mashdup/LEDWallSimulator/(commit log)

2026-10-07 LED curtain wall: browser is the brain, ESP32 is a dumb pixel sink
    1m^2 panel, 400 WS2812B, 20x20 at 50mm pitch. The browser fetches the
    banner, rasterises it, applies effects, budgets the power, and streams
    finished frames. The firmware decodes frames and pushes pixels; it has
    no layout map, no effects, and no idea what a picture is. The sim and
    the wall speak the same frame protocol, so nothing in web/ is throwaway.
    core/ framebuffer, layout map, frame protocol, power model, effects
    (pure JS: no DOM, no fetch, runs under Node so it is testable)
    web/ banner page, canvas sim, live-page capture UI, sinks
    tools/ headless-Chromium capture over CDP + the /capture route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
2026-10-07 name: match the package to the repo
    led-wall -> led-wall-simulator, matching github.com/mashdup/LEDWallSimulator.
    npm rejects uppercase, so the repo's three words land in kebab case.
    Only the package name changes. web/sinks.js CHANNEL stays 'led-wall': it is
    the cross-tab contract both tabs must agree on, not a package identifier.
    plan.md keeps its original 'led-wall/' layout sketch, which is a historical
    proposal rather than a description of this tree.
2026-10-13 lock in: milestones 1-5 as a working tree, panel lit on GPIO 21
    Everything since Oct 7 sat uncommitted, so there was no state to come back to.
    This is that state, as verified on hardware tonight.
    What is here: core framebuffer/layout/pack, the frame protocol with its rewind
    budget, the power budget and clamp, colour, calibration patterns; tools/bridge.js
    (Node driver plus VirtualWall, a port of the sketch's loop), serve.js and
    capture.js (page -> PNG -> frames), png.js, ports.js, start.js; web app.js frame
    loop, sim, banner, panner, and the sim/broadcast/serial/http sinks; firmware.ino
    with APA106/PL9823 bit timing generated straight out of the RMT.
    Verified on the real panel: GPIO 21 driv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
2026-10-13 firmware: STALE_MS=0 disables the watchdog, so a stalled host holds instead of blinking
    The fade exists so that a dead host is visible, but from the wall's side a host
    that merely stalled is identical to one that died. Chrome throttles timers in a
    background tab to ~1 Hz, and to once a minute after five minutes hidden, so a tab
    that is not in front spends longer than STALE_MS between frames and the wall blinks
    black every time it does. Measured: an 18 s stream from Node that stalled once
    reported stale=1 - one blink out of a run that was otherwise perfect
    (disc=0 resync=0 rewind=0 gaps=0).
    With STALE_MS=0 the compare is against a compile-time constant and the branch drops
    out entirely. Veri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
2026-10-13 firmware: report the reset reason and a boot count in the status line
    A board that reboots mid-stream blanks the wall, and from the host's side that is
    indistinguishable from a stream fault: every counter is clean, the panel still
    blinks, and there is nothing to look at. `rst` is esp_reset_reason() and `boots`
    counts resets without a power cycle, held in RTC noinit memory behind a magic word
    so a cold start can be told from a restart.
    This is what ruled out a brownout: full white at br=85 (est=8000 mA, the ceiling
    the 8000 mA default allows) for 585 frames at 30 fps left boots=1, with
    disc=0 resync=0 rewind=0 gaps=0. The supply holds the wall's real load.
2026-10-13 firmware: bank the stream counters in RTC memory so they outlive a reset
    A browser session ends in a reset (rst=11, ESP_RST_USB, delivered through the
    USB-Serial-JTAG interface) and that reset zeroes every counter, so each session
    destroyed the only evidence of what it had delivered. That is why measuring a
    browser session kept returning zeros - the instrument was wiped by the event it
    was meant to observe.
    rtcLive is refreshed once a second and a new boot banks it into rtcPrev, so
    `prev=frames/discarded/rewinds/gaps` in the status line reports what the previous
    session reached. Validated end to end: stream 120 frames, reset the board, and
    the next boot reports prev=120/0/0/0 with boots=2.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
2026-10-13 power: clamp against the worst frame of the recent past, not the frame in hand
    brightnessFor() derived k from the current frame's own ink, so a scrolling banner
    made the wall's global brightness a function of the picture: measured at the
    default 8000 mA budget, k swung between 0.88 and 1.00 through 38 distinct values
    in twelve seconds, and raising the limit to 24000 did not change it. Every byte
    and every counter stayed correct throughout - the decoder reported disc=0
    resync=0 rewind=0 gaps=0 over 1529 frames - which is why this looked like a
    hardware fault for so long.
    The class comment already described the right thing: "the largest brightness
    multiplier that keeps the worst frame SEEN SO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
2026-10-13 docs: the S3 board is 16 MB of flash, not N8R8/8 MB
    `esptool flash-id` on the actual part: manufacturer 0x68, device 0x4018, 16 MB,
    quad, 3.3 V. This file had claimed N8R8/8 MB throughout, which is exactly the kind
    of detail that only bites when you flash someone else's image: tonight it sent me
    to the 8 MB WLED build, and then `--flash-size 8MB` overrode the image's own
    header, so the chip booted into "SHA-256 comparison failed ... Attempting to boot
    anyway" and a TG0WDT reset loop that looks like a dead board.
    Records both traps: esptool reports "Hash of data verified" because it verifies
    with the parameters it wrote, so a mode or size mismatch passes its check and only
    fails in the bootl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
2026-10-13 tools/channels: step each colour channel and watch the panel, and record the method
    No counter on the device can see whether light comes out. `est` non-zero,
    `state=live` and `rmt=1` are all satisfied by a sketch that decodes frames
    perfectly onto a pin connected to nothing, which is exactly the trap this project
    fell into more than once: a green dashboard and a dark wall.
    channels.js sends one channel at a time - RED, GREEN, BLUE, WHITE, OFF, then red
    and blue again - over a solid field, while printing frames, seq, disc, rewind,
    gaps, state and boots from the same port. Counters climbing with one colour
    missing points at that channel's mapping or output stage; counters climbing with
    nothin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
2026-10-13 web: an Adalight sink, so the browser can drive WLED over USB
    The wall is driven by WLED. Its Apa106 RMT method is the only driver proven
    against these beads, and this sketch's own bit timing has never been validated on
    this panel. But the page could only speak this repo's 1203-byte protocol, so
    pointing Web Serial at WLED fed its parser a stream it has no header for.
    AdalightSink frames each record the way WLED's serial realtime input expects:
    'A' 'd' 'a', the LED count high/low, hi ^ lo ^ 0x55, then the record's 1200-byte
    payload unmoved - 1206 bytes on the wire. Meta records are accepted and dropped,
    because WLED has no field for them and brightness rides in the frame bytes.
    SerialSink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
2026-10-13 web: the Adalight header carries the LED count MINUS ONE
    Found by reading WLED's parser rather than guessing. wled00/wled_serial.cpp:
    case AdaState::Header_CountLo:
    count += next + 1; // plus one while reading the two count bytes
    ...
    if (--count > 0) state = AdaState::Data_Red; // consumes exactly `count`
    Adalight's header holds count - 1; that is the convention, not an off-by-one in
    WLED. We sent 400, so WLED read 401 pixels: 1203 bytes off a 1200-byte payload,
    swallowing the next frame's first three header bytes. That header never matches,
    so the whole record is discarded as garbage, and the frame after it may sync
    again - frames landing intermittently.
    Th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
2026-10-13 docs: WiFi starves WLED's serial path, and Adalight's count is LED_COUNT - 1
    Two findings that between them explain a flickering wall with a byte-perfect
    stream, both documented upstream rather than derived:
    wled/WLED#2698 reports Adalight-over-serial glitching "in random colours" and
    traces it to "interference by wifi activity, proportional to traffic to/from
    WLED", with disabling WiFi on the ESP as the workaround. Reproduced on this wall:
    with 400 LEDs streamed at a fixed 16 frames/s, WLED refreshed 12 fps on a quiet
    network and 8 fps while its HTTP API was polled 20 times a second. WiFi traffic
    starves the serial receive path; the frames that lose the race are dropped, and
    Adalight has n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
2026-10-13 docs: the USB-CDC route to WLED glitches on this board - use DDP
    Measured: solid green at 15 fps for 40 s over the S3's USB-CDC port, quiet network,
    nothing else attached, WLED's output off - still glitching. That matches
    espressif/arduino-esp32#9378 ("[HWCDC] Missing data via USB Serial on C3/C6/S3"),
    which reports the S3 dropping bytes on its native USB serial.
    Adalight has no resync, so one dropped byte corrupts the rest of that frame and the
    frame after it. Both USB attempts here - the Node probe and the browser's adalight
    sink - glitch for that reason. It is a platform fault, not a framing one: the count
    field and checksum are now verified correct against WLED's parser, and the frames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
2026-10-13 docs: the venue runbook - WLED's own AP plus DDP, no infrastructure needed
    A party has no WiFi network, which rules out the DDP route as previously framed but
    not the idea: the wall needs a link between the laptop and the ESP32, not the
    internet, and WLED provides that link itself. Set AP Behaviour to Always, join
    WLED-AP from the laptop (192.168.4.1 by default), point the dev server at it with
    --ddp, and drive the app's http sink. Only the DDP datagrams leave the machine.
    DDP is also the one path that this evening measured clean on this panel - 42
    frames, 0 dropped, smooth sweep, smooth banner - and it is unaffected by the WiFi
    activity that starves the serial route, because it is the netw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
2026-10-13 wled: a custom build whose serial sink resyncs, so the offline route works
    WLED drives this panel smoothly with its own Apa106 RMT method, and the sketch drives
    it smoothly over Web Serial, but WLED-over-serial flickers. The failure is the
    transport, not the framing: the ESP32-S3's native USB serial loses bytes
    (espressif/arduino-esp32#9378) and Adalight has no resync, so one lost byte corrupts
    the rest of that frame and the next. WiFi makes the drops worse (wled/WLED#2698).
    This adds a tracked overlay over a pinned WLED clone (the clone itself is ignored;
    setup.sh fetches it). It changes two things and nothing else. First, the sink speaks
    the repo's own 0xA5/0xA4 records, decoded exactly a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
2026-10-13 docs: the custom WLED sink is verified on the panel - USB-OTG costs frames, not pixels
    Flashed led_wall_s3_usb to the board (COM6, the S3's own USB-OTG) and the panel
    lights, renders the calibration cycle and holds it steady. Driven with the repo's
    own host, `node tools/bridge.js --port COM6 --cycle --duration 15000`, the sink
    reported 305 frames sent, 295 decoded, and disc=resync=rewind=11: ten lost-byte
    events, every one self-healed by the rescan, and zero corrupted frames.
    That is the point of the build. The transport is still the buggy USB-CDC port and
    still drops about 3% of the bytes, but the resync that core/frame.js already
    specified turns each loss into a skipped frame; Adalight, w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
2026-10-13 docs: the UART build is lossless - 400 of 400 frames, no discards, no rescans
    Moved the cable to the board's UART port (the CH9102F, VID_1A86&PID_55D3, came up as
    COM8) and flashed led_wall_s3_uart. Same firmware and same framing as the USB-OTG
    build; the only difference is that Serial is on UART0 instead of the S3's native USB.
    A moving gradient at 20 fps for 20 s: 400 records sent, frames=400, meta=1,
    disc=0 resync=0 rewind=0 gaps=0, state=live. Nothing lost, nothing discarded,
    nothing rescanned. Repeating it with one frame deliberately a payload byte short
    gave disc=1 resync=1 rewind=1 across 240 good frames - every real frame still
    arrived and the corruption stayed confined to the frame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
2026-10-13 wled: silence the radio on the UART build, by compiling the manager out rather than racing it
    Turn the ESP32's radio off for the streamed wall (wled/WLED#2698) and keep it off.
    The obvious version does not work, and trying it produced a worse wall than leaving
    WiFi on, so the measurement is worth recording.
    WiFi.mode(WIFI_OFF) does not hold on its own: WLED::handleConnection() runs every loop
    and re-inits the stack whenever it believes it is disconnected. Instrumented with a
    woff= counter, the radio came back every ~9 s and the usermod took it down again each
    time - frames=91 disc=0 resync=0 woff=1, then frames=109 disc=6 resync=1159 woff=2,
    then frames=281 disc=12 resync=2027 woff=3. A tea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
2026-10-13 tools/wallcheck: stream the wall and read its counters in one connection
    The device counters are the only thing that can say "the bytes arrived" from "the
    bytes were lost", and reading them the obvious way lies twice.
    The CH9102F asserts DTR/RTS on open and this board's auto-reset circuit is wired to
    it, so opening the port reboots the ESP32. Read the counters in a different
    connection from the one that streamed and the answer is always a freshly-booted
    zero - which is exactly how the first bridge.js runs looked like frames=0 while the
    wall was fine. And a still wall is not re-sent frame by frame, so a static pattern
    measures almost nothing; this streams a moving gradient where every frame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
2026-10-14 tools/wallcheck: verified on the wall, and the one reset gap is a restart rather than a fault
    First hardware run, and the tool was wrong before the wall was: the transport came
    back clean - disc=0 resync=0 rewind=0, 300 of 300 frames decoded - and wallcheck
    still failed the run on gaps=+1.
    The gap is the stream restart. The sink tracks the last sequence it saw so it can
    report a dropped frame, but it does not print that number back, so a fresh run cannot
    continue it and this tool always starts at 0. On a board that has already been
    streamed to, the first frame of every run is therefore one gap, and failing on it
    would fail every healthy run. Past that one, a gap is still unexplained and sti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
2026-10-14 layout: calibrated on the real panel - columns of 20, straight, top->bottom
    Milestone 5, read off the wall with WALK and INDEX_MAP: index 0 is top-left,
    each strip runs down a column and restarts at the top of the next column
    left->right, 399 is bottom-right. Not serpentine. core/layout.js defaults are
    now stripAxis 'y', snake false, no flips: index = 20*col + row.
    identity() now pins stripAxis 'x': its contract is physical == logical, and
    the new default was silently making it column-major. preview() joins columns
    with a space: padStart(3) cannot separate adjacent 3-digit indices, which the
    column layout's first row (0,20,...,380) hits.
    Verified end-to-end: a logical top-left 'F' packed t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
2026-10-14 web: brightness was applied twice - the wall showed k-squared
    The page scaled the frame bytes by the power clamp k AND carried k in the
    meta record; the sketch folds the meta brightness into renderWall() and the
    DDP transport applies it to the frames that follow, so the serial and DDP
    walls displayed k*k. The bridge never scaled bytes - brightness rode only
    in meta - which is why the same wall was bright through tools/bridge.js and
    dim through the page.
    Brightness now applies once, at the sink:
    - the wire carries raw bytes; meta carries the clamp.
    - meta is re-sent when the clamp moves, so the wall's applied brightness
    tracks k instead of freezing at whatever the first frame asked for.
    -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
2026-10-14 power: full white spiralled k to the floor - the wall sat at br=13/255
    Two faults, one panel:
    brightnessFor returned a local k while observe() decayed this.k and toMeta()
    reported this.k - two brightness states. The page applied one and the wall
    was told the other.
    observe() fired its multiplicative decay against effectiveLimitMa, the very
    margin brightnessFor aims a clamped frame at. A full-white panel at limit
    18000 lands the rendered estimate at 16260 mA against the 16200 target -
    integer rounding a hair over - so every frame multiplied k by ~0.9996 with
    no recovery path. Sustained white spiralled to the minBrightness floor:
    k=0.05, meta br=13, a dull wall at 5% with the slider looking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
2026-10-14 web: headroom changes the margin, so its handler must reset the ratchet
    The adaptive ceiling is one-way by design - only reset() brightens the wall
    back - and the limit slider honoured that contract while the headroom slider
    did not. Raising headroom clamped k (visible: the wall dims); lowering it
    recovered nothing, because the ratchet held the clamp and the wall was never
    told. The handler now mirrors the limit handler: set the margin, reset, and
    re-send meta so the wall's applied brightness rides the reset k.
    Regression test: full white at 18000 mA, headroom 0.1 -> 0.9 -> 0.1. The
    clamp hardens on the way up, the ratchet provably holds without a reset,
    and a reset returns k to the 0.675 t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
2026-10-14 docs: the power envelope is the ribbon, measured - 6-7 A, supply-independent
    Probe test on the live wall: the last column alone at full white is very
    bright, so the far corner gets full voltage at low current. Lighting
    columns progressively, the probe dims at 5 columns (~6-7 A), and the
    full-white ramp knee sits near 42% ink. A 20 A and a 40 A supply made no
    difference - the ribbon, not the supply, is the ceiling. Full white's 24 A
    is unreachable; br above ~100 buys heat, not light.
    The ribbon ran cold to the touch and the page's 8000 mA default keeps the
    estimator's margin just above the collapse zone, so it stays. The
    headroom move, if brightness must grow, is a second power pair to the f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
2026-10-14 web: content.html - the companion canvas the wall renders
    A 400x400 canvas, 20 css px per LED cell, black is off, pixel-aligned
    blocks map 1:1 through the capture's area-average. window.WALL is the
    script API for the interactive webapp that follows: set/rect/clear, grid,
    cell, ctx, canvas - draw from rAF and the wall follows at the poll rate.
    ?wall=1 hides the human panel so the page is exactly 400x400: a page
    taller than the capture viewport gets shot as a scaled full-page image,
    and the panel text bleeds into the wall's field of view. Verified through
    the real pipeline: capture route -> 1:1 PNG -> pageSource at 20 px/cell,
    no pan -> live animation on the physical panel.
    App settings: sou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
2026-10-14 web: worker clocks - the stream and the canvas survive a hidden tab
    Chromium throttles a hidden tab's timers to ~1 Hz and stops
    requestAnimationFrame entirely. The app's 30 fps setTimeout loop crawled
    at ~1 fps the moment the tab lost focus, and content.html's rAF demo
    froze - the wall slowed or stalled whenever either tab went to the
    background.
    Workers are exempt from background throttling and their postMessage
    handlers run at full rate on the main thread, so the tempo moves into
    one: web/worker-clock.js is a Blob worker that ticks at a fixed period,
    and both pages drive off it. The app keeps full frame rate with the tab
    in the background; the content canvas animates with the tab hidden.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
2026-10-14 web: silent-audio keep-alive - Chrome throttles hidden tabs' workers too
    The worker clock kept the tempo off the main thread, but Chrome 88+
    aligns the timers of a hidden page's WORKERS to ~1 Hz as well: an
    unfocused app tab streamed at 1 fps, measured. The documented in-page
    escape is the audio exemption - a page with an active audio stream is
    not background-throttled.
    keep-alive.js opens a WebAudio graph that is inaudible in practice (an
    oscillator under a gain of 1e-5) and starts it from a gesture the user
    already performs: Connect on the app page, demo on the content page.
    Idempotent, one stream per page.
    worker-clock's doc now says what is actually true: the clock beats
    main-thread sc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
2026-10-14 content protocol: the driver tab can now drive the content page
    content.html was an island: the wall rendered it, but nothing on the
    driver side could say what it should show. BroadcastChannel + a
    validated protocol in core closes the loop: the app page grew a Content
    control fieldset (Send text / Fill / Clear / Demo) and content.html
    consumes the commands - text scrolls through the same core Scroller the
    app's text mode uses, so one banner implementation serves both hosts.
    core/content-protocol.js is the single authority: makeMessage throws on
    an illegal payload (a broken sender fails loudly at its call site),
    parseMessage drops anything malformed on the receiving side (a content
    page neve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
2026-10-14 content: animation library + control gallery
    Six new named animations, each a pure function of the server clock -
    no local state, no Math.random (deterministic hashed texture), so every
    renderer - tabs, control pages, the wall's capture browser - is in
    phase at the same second:
    bounce ball on Lissajous paths with a fading trail
    rain column drops at hashed speeds, bright head, fading tail
    fire hot base, heat decaying upward, noise scrolled by time
    plasma three overlapping sine waves, hue from the sum
    bars equalizer waves, green/yellow/red by height
    clock real wall clock from the server epoch - the wall keeps time
    Protocol: ANIM_NAMES is the anim vocabulary (demo, bo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
2026-10-14 content: wrap the epoch clock before periodic math - fixes jitter
    Phase t is seconds since the epoch (~1.8e9). t*12 sits at 2e10, where
    a double's spacing is ~4000: (t*speed) % 26 quantizes into thousand-
    cell jumps, hue = ... + t*12 quantizes into thousand-degree jumps.
    Rain teleported, plasma flickered, everything read as 'constantly
    restarting' - arithmetic precision, not animation state.
    animDraw now wraps t to one hour before any periodic expression (the
    wrap discontinuity is once an hour, invisible), and 'clock' - the one
    animation that must see the raw epoch to show real time - takes tRaw
    separately.
2026-10-14 serve: GET /content.at is the server's CURRENT time - fixes sawtooth clock
    Renderers rebase their animation clock on every poll:
    serverNow = GET.at + elapsed-since-poll. But GET returned content.at -
    the timestamp of the LAST POST - so every 100 ms poll snapped every
    page's clock back to the moment of the last command. Animations
    advanced 100 ms, got yanked to the start, advanced, yanked: 'constantly
    redrawing from the start', measured as an oscillating pixel sample
    (39,22,39,27,18,27,18,43) and now as smooth monotonic drift
    (10,14,31,51,75,112,153,194).
    GET.at is Date.now() at request time; the POST time stays as postedAt.
    Regression test: two GETs 300 ms apart must show at advancing - the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
2026-10-14 content push: the wall fetches the page's own frames - 3x the rate
    The /capture route photographs a page at 60-90 ms per shot: the wall's
    content rate topped out near 10 fps no matter what the app's 30 fps
    loop wanted - the observed 'closer to 15, not smooth'. Remove the
    photographer: content.html POSTs its canvas to the server after every
    draw; the app fetches the freshest bytes in a few milliseconds.
    The pushed frame is a 20x20 snapshot - that IS the wall's resolution.
    Encoding 400x400 (PNG ~100 ms, JPEG ~90 ms, measured headless) capped
    the push near 8-10 fps; 20x20 JPEG encodes in ~1 ms and the push runs
    at the full draw rate (measured: every fetch in 2s returned a new
    frame). Auto-zoom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
2026-10-14 app tab generates the wall's frames - a hidden content tab can't freeze it
    Measured diagnosis: the push pipeline ran ~21 fps with a live content
    tab, but the user's hidden content tab pushed at 0.3 fps - Chrome
    throttles hidden tabs (and their workers) hard, and the wall froze on
    the last frame it saw. The pusher was the weakest link: any hidden tab
    can starve the wall.
    Move frame generation to the app tab - the driver holds the audio
    keep-alive from the Connect click, is never throttled, and is the
    brain anyway. core/animations.js is the library in canvas-free pure
    form: animFrame(state, serverTime) -> flat RGB, the same phase
    discipline as content.html (epoch wrapped to an hour before per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
2026-10-14 app: 'Content - server push' feed (presets as a unit) + y-axis layout default
    The push pipeline's five page-mode fields (endpoint, refresh,
    auto-zoom, speed, URL) are one decision, and one field set wrong is a
    frozen or stuttering wall. New Feed option 'Content - server push'
    applies them together: endpoint /content/frame (the app tab generates
    frames, never throttled), refresh 34 ms (one poll per tick), auto-zoom
    on (the pushed frame is 20x20 - the wall's own resolution), speed 0
    (panning a 20x20 source is a shake), URL this server's content page.
    Layout dropdown now defaults to the calibrated mounting - '20x20
    columns of 20 (straight)', stripAxis 'y' from LAYOUT_DEFAULTS - not
    identity, w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
2026-10-14 app: leaving the content feed restores capture defaults
    The content feed's presets leaked: Content -> Live web page left
    endpoint=/content/frame, and the frame route ignores the url
    parameter - page mode answered every poll with the pushed 20x20
    frame, so the page capture looked completely dead. Reproduced in a
    real browser: after switching back, endpoint still read
    /content/frame.
    Presets that go in pairs go out in pairs: setSourceMode('page')
    restores endpoint /capture and refresh 150 ms. Verified: after
    content -> page, a real URL captures (1280x800, 45 ms round trip).
2026-10-14 page: a source without a hash must DECODE - fixes the frozen content feed
    PageSource.refresh decoded only when X-Capture-Hash changed. The push
    route sent no hash: key=null, initial key=null, 'null !== null' is
    false, so the first frame was never decoded - the content feed sat at
    'capturing…' forever, 0 captures, black wall. The comment claimed a
    null key meant 're-decode every poll'; the code did the opposite.
    - page.js: key === null now means decode.
    - serve.js: the push route sends X-Capture-Hash (sha256 of the frame)
    and X-Capture-Ms (frame age), the same contract /capture offers, so
    identical frames skip decode and the readout shows real latency.
    - app.js: any first pointerdown a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
2026-10-14 push: PNG not JPEG at 20x20 - pixel art demands exact colors
    JPEG's 8x8 blocks are 40% of a 20x20 frame each, so compression
    artifacts land directly on LED cells: the demo's orange square came
    out light orange ringed with red/green. JPEG was right at 400x400
    (where encoding was the bottleneck); at the wall's native 20x20,
    PNG encodes in ~1 ms and is lossless.
    Measured in a real browser: push ~19-29 fps (probe-capped), decoded
    frames contain the exact source palette - demo orange (255,136,0)
    and green (0,255,102) pixel-exact, zero artifact pixels. (The
    'other' colors in one probe were fire embers: the live control tab
    was driving the server state. Exact values, lossless confirmed.)
2026-10-14 keep-alive: be AUDIBLE to Chrome, or the exemption never applies
    Chrome's hidden-tab throttling exemption is for tabs it measures as
    playing audio, and the measurement is amplitude-based with a floor
    around -50 dB. The keep-alive sine at 1e-5 gain (-100 dB) is below
    that floor: Chrome heard nothing, applied throttling anyway, and a
    backgrounded app tab crawled (measured in headless: 4.4 fps hidden
    vs 32 fps visible; the silent and audible gains measure identically
    in headless because it has a fake audio device and no audible
    detection at all).
    Now: 0.02 gain (-34 dB, comfortably above the floor) at 19.5 kHz -
    Chrome flags the tab audible and exempts it; almost no adult hears
    a 19.5 kHz tone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
2026-10-14 keep-alive: escape BOTH throttling tiers - media element for the 5-minute cliff
    Symptom: smooth for a few minutes hidden, then 1 Hz. That is Chrome's
    intensive throttling: after ~5 minutes hidden, timers drop to one
    wake-up per minute. The audible WebAudio sine escapes the STANDARD
    tier (hence the smooth minutes) but not reliably the intensive one.
    The documented escape for the intensive tier is active media
    playback, so the keep-alive is now both:
    - tier 1: audible WebAudio sine (19.5 kHz, -34 dB) - immediate
    hidden-tab throttling
    - tier 2: a looping <audio> element playing the same tone as a
    runtime-generated 1-second WAV data URI (no asset, no network) -
    the media-playback exemptio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
2026-10-14 start: --app was dropped on the no-port path - npm run wall opened a tab
    The real bug, found by instrumenting the call site: parseArgs has two
    returns, and the no-port early return omitted 'app'. Plain 'npm run
    wall' (no --port) therefore ran with app=undefined and fell through
    to openInBrowser - a tab in the default browser. Every verification
    I ran passed --port, took the explicit-port return (which had 'app'),
    and saw a real app window - so the tests proved the flag worked while
    the user's exact command silently ignored it.
    Fix: the early return carries app too. Verified with the user's flow
    (plain 'npm run wall', fallback port): run 1 chromeH=39 APP WINDOW,
    run 2 chromeH=39 APP WINDOW.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
2026-10-14 electron: the wall as a real app - tab lifecycle removed at the root
    Direction change after the Chrome --app whack-a-mole (throttling
    tiers, occlusion, delegation, session restore, and --no-sandbox
    measured to silently kill app mode): Electron is the same Chromium
    engine with the lifecycle owned by the app.
    - tools/electron/main.cjs: one window, no menu, backgroundThrottling
    false (OUR decision, not a tab policy), single-instance lock that
    focuses the existing window, Web Serial granted with a
    programmatic port picker (COM8 preferred - the wch.cn USB-UART),
    fixed title 'LED Wall'.
    - start.js --electron: boots the server, launches the app, relays
    its output with an 'electron:' pref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
2026-10-14 electron: dedicated userData dir + legible single-instance outcome
    'npm run wall exited (code 0)' was the single-instance lock working
    against a leftover test instance: the newcomer focused the old
    window (pointing at a dead test server) and quit silently, while
    two instances fought over the default %APPDATA% cache dir
    ('Unable to move the cache: Access is denied').
    - userData moves to .wall-electron in the repo (known location,
    gitignored).
    - The newcomer now SAYS what happened: 'another wall instance is
    already running - focused it', with the fix (close the old one).
    - The launcher relay drops the newcomer's transient cache errors;
    everything else stays visible.
    Verified: launch 1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
2026-10-14 electron: drop windowsHide - the window was born hidden
    'Started, no window' measured at the OS level: all 4 electron
    processes alive, MainWindowHandle = 0 - no window on the desktop -
    while the renderer loaded and show() fired. windowsHide:true sets
    STARTF_USESHOWWINDOW/SW_HIDE on the process, and Electron's browser
    window HONORS that startup hint (Chrome's --app window did not,
    which is why the same flag looked harmless before). Without it,
    MainWindowTitle 'LED Wall' appears. Electron is a GUI binary, so
    there is no console window to hide anyway.
    Also: createWindow now shows on ready-to-show with explicit
    center() + focus() and logs its bounds, so 'no window' is
    answerable from the launch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
2026-10-14 electron+app: a serial connection must name its device
    'COM8 isn't connected, clicking Connect says connected, nothing
    works': the programmatic picker fell back to ports[0] - with the
    panel unplugged that is some unrelated COM device (Bluetooth,
    audio). open() succeeds on it, writes go into a void, the UI says
    'connected: serial' over a dead wall.
    - main.cjs: match the DEVICE, not the COM number - wch.cn
    usbVendorId 0x1a86 / 'USB Serial' / CH34x product strings, COM8
    as a hint only. No candidate -> REFUSE, and log the full port
    list with product names to the launcher (the old picker matched
    'COM8' in the path, but the wch UART reports usbProductName
    'USB-SERIAL CH340' - the real d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
2026-10-14 electron: picker read the WRONG port struct - Electron's SerialPort
    Field log: '3 port(s): undefined[?], undefined[?], undefined[?]'
    while Windows had CH343 on COM8. The select-serial-port portList is
    Electron's SerialPort struct - portName, displayName, vendorId/
    productId (strings), deviceInstanceId (win32) - NOT the Web Serial
    API's SerialPortInfo (path, usbProductName, usbVendorId) I matched.
    Every field read was undefined, so the CH343 never matched and the
    picker refused a healthy device.
    Match on Electron's real fields: displayName wch|ch34|usb serial,
    vendorId '1a86', deviceInstanceId vid_1a86, portName COM8 hint,
    then any COMn. Raw objects are dumped per request so the next
    diagnos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
2026-10-15 serial pre-flight: name a taken port before Connect, not after
    A COM port is exclusive; when the Arduino monitor (or a stale
    bridge) holds COM8, port.open() fails with the opaque 'Failed to
    open serial port' AFTER the click, with no hint who holds it.
    - tools/serial.js: PowerShell test-opens each COM port from
    outside the app -> [{port, state: FREE|BUSY}], cached 3 s.
    Documented side effect: opening toggles DTR/RTS, which reboots
    a connected ESP32 - so the app probes on load, not on a timer.
    - GET /serial in serve.js (no-store).
    - app.js: on load, busy ports surface as
    'warning: COM8 in use by another program - close its serial
    monitor before connecting' in the sink status.
    - 4 te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
2026-10-15 freeport: force-disconnect = find the holder, name it, kill it
    Windows COM ports are exclusive and no API closes another process's
    handle; the only 'force disconnect' is terminating the holder. The
    pre-flight says 'COM8 is busy' - this names WHO.
    tools/freeport.js: the handle.exe algorithm via PowerShell Add-Type.
    NtQuerySystemInformation enumerates every handle; duplicate + type
    each. Measured census on this machine: serial handles are object
    type 'File' (there is NO 'Device' type), and naming File objects is
    the classic NtQueryObject hang (pipes) - so File handles are named
    on 16 parallel worker threads with a 100 ms budget, hung queries
    abandoned (background threads; the probe process ex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
2026-10-15 app: control page folded into the main view; layout UI simplified
    Content control was a BroadcastChannel stub pointing at the companion
    page - dead weight now that the app tab generates frames and the
    server is the source of truth. The control page's power is now IN
    the app:
    - Content fieldset: text (Enter sends), fill, clear, and the full
    animation gallery (8 buttons from ANIM_NAMES). Commands POST to
    /content - validated by makeMessage here, parseMessage at the
    server.
    - Status mirrors the server on the SAME 100 ms poll that drives
    frames (no second fetch loop): 'server rev N - showing: rain',
    and the live animation's button is lit (.on) so the panel shows
    what the wall shows.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
2026-10-15 serial: probe timeout crashed the SERVER - the two regressions explained
    'Connection doesn't work + content feed blank' after the pre-flight
    landed: tools/serial.js's timeout timer called ps.kill('ignore').
    'ignore' is a POSIX-only signal convention; on Windows it throws
    ERR_UNKNOWN_SIGNAL. The timer runs on the dev server's event loop,
    so a PowerShell cold start slower than the 5 s timeout (measured:
    it happens) raised an uncaught exception and took the whole server
    down. Every symptom follows: no /content (blank feed), no /serial,
    Connect dead - all blamed on the app.
    - Valid signal only (SIGTERM/TerminateProcess), wrapped in try/catch.
    - Timeout 5 s -> 15 s: PowerShell cold start measure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
2026-10-15 text: the banner SCROLLS - seek() takes cells, not a fraction
    'Word appears, never moves': the frame pusher fed Scroller.seek()
    the pass FRACTION (0..1) where seek takes a CELL offset in
    [0, period). The text rendered under one cell from the start and
    wrapped every pass - visible, and stone still. Both renderers had
    the same line (app pushContentFrame and content.html's draw loop).
    Fix: fraction * scroller.period. Verified in a real browser: two
    pushed frames 1.5 s apart differ (lit-pixel hash moves as the
    banner passes).
    Regression test (content-sync): app tab on the content feed, POST
    text, two /content/frame fetches 1.5 s apart must NOT be
    byte-identical PNGs - a frozen banner is now a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
2026-10-15 css: responsive layout - the page stopped outgrowing its own width
    The app page scrolled sideways: the sim sat half off screen and the
    control panel ran past the window. Four compounding causes, all
    structural (no media query fixes a min-content floor):
    - Grid tracks: minmax(360px,1fr) + minmax(340px,420px) set hard
    floors (~760px total), and grid ITEMS default to min-width:auto,
    so a long readout or the long wallLayout option widened tracks
    past the viewport. Tracks are now minmax(0,1fr)/minmax(300px,420px)
    and .stage/.panel/fieldset carry min-width:0.
    - .row never wrapped: the content fieldset alone carries eleven
    buttons (send/fill/clear + the 8-anim gallery) in one flex line.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
2026-10-15 serial: reset into RUN MODE on open - kill-and-relaunch worked no more
    Kill the app while connected, launch again, Connect succeeds, the
    wall is dark. The app's death leaves DTR/RTS at an arbitrary level,
    and the ESP32 auto-reset circuit (DTR->IO0, RTS->EN through
    transistors) reads that as 'stay in the bootloader'. The port
    opens, writes succeed, nothing arrives - 'connected' over a dead
    wall, nothing in any log to say why.
    Fix: SerialSink.open() pulses an esptool-style hard reset after
    opening - IO0 released (DTR deasserted), reset pulsed on EN (RTS),
    released - the chip reboots into the firmware. Frames that arrive
    during the ~2 s boot are discarded by the parser's 0xA5 resync,
    not mis-p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
2026-10-15 start: --debug flag - Electron DevTools on 127.0.0.1:9223
    'Connected, wall dark' and 'connect failed' look identical from the
    launcher log. The app page's own state (fps counter, seq, sink
    status, last frame error) is the evidence, and Electron exposes
    none of it by default. 'npm run wall -- --debug' passes
    --remote-debugging-port=9223 to Electron so the app page can be
    inspected from outside while the show runs.
2026-10-15 electron --debug: interpret the flag as an APP arg in main.cjs
    Everything after main.cjs on the Electron command line is an app
    argument, not a Chromium switch: passing --remote-debugging-port
    raw from the launcher did nothing (9223 never listened). main.cjs
    now sees '--debug' in process.argv and appends the switch
    programmatically before ready.
2026-10-15 start: wire --debug through; kill zombie serve.js at startup
    Two gaps from the kill-and-relaunch investigation:
    1. --debug never reached Electron: an earlier multi-edit call fails
    atomically (one oldText missed -> ALL edits discarded), and only
    one of the three was re-applied. serveOnce never took the debug
    parameter and openElectronWindow(ready[1]) never passed it. Now
    wired end to end; verified the arg reaches the spawn.
    2. The root cause of 'kill the app, relaunch, connect fails': a
    dead launcher's tree does not always die - the orphaned serve.js
    holds port 8080 (new show lands on a random port, splitting the
    stack) and the orphaned Electron holds COM8 (open() fails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
2026-10-15 anim: 'snitch' - the Golden Snitch, HP-themed
    A night sky of faintly twinkling hashed stars, and a gold comet
    darting along a noise-perturbed Lissajous - the erratic flit of
    something with wings. Analytic trail (past positions sampled from
    the same pure function, fading gold), glow cross around the core.
    Pure function of server time like every animation: identical frame
    in every renderer at the same second, no state, no local clock.
    Registered in ANIM_NAMES (gallery button appears automatically);
    implemented in both renderers (core/animations.js for the app's
    frame push, content.html's inline library).
    Tests: the ANIM_NAMES-driven suites cover it automatically (lit,
    advances, pure); a dedi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
2026-10-15 connect: clear the DRIVER-level port lock (the works/fails/works alternation
    The measured pattern - fresh app works, close, relaunch fails, close,
    relaunch works - is not a process holding the port (freeport finds no
    holder in the failing state): the wch driver leaves the port
    un-openable for a while after a connected app closes. The tell is
    that the FAILING instance cleans up for the NEXT one: the serial
    probe test-opens every port on page load, and that open/close
    releases the zombie lock - so the failed instance's probe is what
    makes the third launch work.
    Takeover now handles the no-holder case: open fails, scan finds no
    process holder -> the lock is in the driver -> run one fresh probe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
2026-10-15 serial: THE PULSE WAS THE BUG - DTR asserted = IO0 HIGH (esptool reset_to_run)
    The report: relaunch says 'connected: serial - COM8', the app
    streams, and the wall is dark - and the failure ALTERNATES
    (works, fails, works). Case 2: the port opens fine; the chip is
    stranded in the bootloader.
    Root cause, from the classic DTR->IO0 / RTS->EN transistor circuit:
    DTR asserted -> Q1 off -> IO0 HIGH -> boots into FIRMWARE
    DTR deasserted -> Q1 on -> IO0 LOW -> boots into BOOTLOADER
    The dcba5d7 pulse left DTR deasserted while pulsing RTS - so the
    chip came out of reset with IO0 LOW: straight into the bootloader.
    The rescue pulse itself was the stranding. And the driver's close
    defaults (bot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
2026-10-19 draw: a 20x20 editor, a server-side gallery, and pic/gallery content
    The wall is a family noticeboard as much as a data display, so anyone who
    can reach it can put a picture on it.
    - core/drawings.js the model: one flat RGBA grid, 4 bytes per cell,
    20x20 = 1600 bytes; the wire form is lowercase hex of those bytes
    (3200 chars). Alpha is the whole transparency story - a cell with a=0 is
    NOT USED, so it renders as nothing and the wall's black shows through.
    Empty is not white and not black: it is off, which is what a curtain of
    LEDs does with a cell nobody addressed.
    - web/draw.html standalone editor, touch-first: pencil / eraser /
    bucket, native picker + quick palette + rec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
2026-10-19 anim: the APP driver played the demo where a drawing belongs
    Reported straight after the drawing feature: send a drawing, the wall shows
    the demo animation. There are TWO frame renderers and only one of them
    knew about the new kinds. content.html paints pic/gallery; when the wall
    runs in the app's content feed - the normal mode, because the app tab holds
    the audio keep-alive and a hidden content tab throttles to ~1 Hz and
    starves the push - the frames come from animFrame(), whose switch had no
    pic/gallery case, so both fell through to default: the demo.
    - core/animations.js pic paints its own cells (a=0 is zero, the wall's
    off state; junk pixels give a black frame, never a throw, because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
2026-10-19 web/draw-editor.js: the editor, lifted out of draw.html
    draw.html and the guest page need the SAME editor - the model, the pointer
    stroke, the undo stack, the flood fill, the tool and color state - and only
    the LOOK and the exits differ. Duplicated, the two would drift, and the drift
    would show up as "it looks right here and wrong there", which is the one
    failure a drawing app must not have.
    The editor owns core's RGBA bytes and paints them through a `paint` callback
    the page supplies: the owner's grid stays graph paper, the guest's grid can
    read as a lit LED matrix, and neither page can disagree about what a drawing
    IS. The canvas is the only DOM the editor touches; the page keeps its own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
2026-10-19 public.html: strip the guest page to the grid, the tools and one button
    The wall panel is out: the "20x20 - 400 LEDs" badge, the subtitle, the "on the
    wall right now" panel and the thumbnail strip. A stranger with a phone does not
    need to know what the wall is showing, and every one of those was a read of the
    wall's state - a 2 s poll of /content, a 6 s poll of /drawings, a pixel fetch per
    entry, a clock offset, a countdown. The page now reads NOTHING.
    That turns the capability boundary from a rule into a fact: the only request the
    guest page can make is the save, and the test asserts it completely - the whole
    fetch log is ['POST /drawings'], zero WebSocket constructions, the content rev
    id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
2026-10-19 serve: the guest guards - a per-address post limit and two kinds of delete key
    The guest page is the one handed to strangers, and every limit it had lived in
    that page's JavaScript - a speed bump a tab devtools walks straight past. The
    guards move to the server, where the page cannot be talked out of them.
    - rate: a per-address spacing (10 s) and burst window (6 per 60 s) on
    POST /drawings, plus a gallery size cap (200). The address is the SOCKET
    address: X-Forwarded-For is forged by exactly the client the limit exists for,
    and this server is loopback-bound with no proxy that would set it truthfully.
    A REJECTED post records nothing - if it did, hammering would push one's own
    locko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
2026-10-19 web: the guest takes its own drawing back, the owner prunes with a token
    The client half of the guards.
    public.html: the save response carries a per-entry delete secret, kept in this
    browser's storage, and the thank-you card grows a "Take it back" - the guest's
    own undo, opened by the guest's own key. A refusal is now a sentence a guest can
    act on: 429 shows the server's own words and the page adopts its Retry-After as
    the cooldown, 507 says the gallery is full and to ask the owner, and the button
    re-enables on the server's schedule, not the page's.
    draw.html: the owner token, remembered per browser, sent as X-Wall-Owner, and
    the reason a removal was refused - "owner token needed - the ser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
2026-10-20 gallery: a break between drawings, filled by an animation from the wall's own library
    A gallery of family drawings is a slideshow, and a slideshow with no rest is one
    nobody watches. Each drawing now shows for `interval` seconds, then the wall
    runs one of its own animations for `gap` seconds, then the next drawing.
    The break is NOT a timer. It is a slot in the same clock arithmetic as the
    drawings, in one pure function - gallerySlot(tSec, n, interval, gap, gapAnim) -
    so a capture browser that loads fresh mid-cycle, a phone tab open since dinner,
    and the app tab that drives the frames all land in the same slot of the same
    cycle. Nobody starts it, nobody syncs it, a renderer that reloads mid-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
2026-10-20 gallery: transitions between slots - fade, wipe, slide, dissolve, as pure bytes
    A gallery with a break is a slideshow that rests; with a transition it is one
    that arrives. Each slot opens by blending in: the frame the wall was on, the new
    drawing, and k going 0..1 over transitionSec seconds. Default fade, 1 s.
    core/transitions.js is the effect library, pure bytes:
    applyTransition(name, from, to, k, grid) -> Uint8Array.
    - fade is linear. wipe reveals whole columns with a LIT LEADING EDGE: on a
    20-cell panel a bare 0/1 reveal reads as a jump, and the moving edge is what
    reads as a sweep. slide moves one picture in from the right and carries the
    other off the left as ONE movement, so th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
2026-10-20 web: the gallery cadence in the console; test: waitFor was never awaiting its predicate
    The app page is the console a person has open at the wall, and its content panel
    was still the pre-gallery one: text, fill, clear, anim buttons. The cadence now
    lives there too - every N s, break M s of <anim>, transition <name> K s, Start
    gallery - with Draw… and Guest page links and the drawing count. The selects are
    built from GAP_ANIM_NAMES and TRANSITION_NAMES, the same lists the gate
    validates, so the console cannot offer a value the wall would refuse.
    The console MIRRORS: a cadence set from a phone opens the fields on the console,
    and Start lights when the wall is in gallery mode. The mirror run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
2026-10-21 the wall takes guests over the internet: a relay it dials out to
    A party's phones are not on the wall's network, and the wall is a laptop
    behind NAT whose server is loopback-bound on purpose (Web Serial needs a
    secure context, and http://192.168.x.x is not one). So the wall cannot be
    reached, and should not be: the console, the serial panel and the frame
    driver stay off the network. The relay is the public door, and the wall
    visits it.
    phone --HTTPS--> Caddy --> relay (Docker, loopback:8091) --> /data
    ^
    | GET /pull?since=N POST /push
    wall laptop (loopback:8080, serial to the panel)
    A queue, not a proxy: a proxy puts the wall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
2026-10-21 the container must bind 0.0.0.0 inside: -p forwards to eth0, not to loopback
    The relay followed this box's loopback convention one layer too deep. The
    host-side mapping (127.0.0.1:8091) is the discipline that keeps the internet
    out; inside the container, Docker's -p forwards to the container's eth0, and a
    server bound to loopback in there is unreachable - the mapped port answers with
    an empty reply. RELAY_HOST=0.0.0.0 in the compose file, with the reason next to
    it.
2026-10-21 the Caddy edge limit is off, and the reason is in the file
    Caddy's rate_limit directive is experimental in v2.11 and caddy run on this box
    carries no --experimental flag: adding the block makes the whole Caddyfile fail
    to load, and that Caddyfile serves every site on the machine. The relay's two
    gates do the job; the shape of the edge limit is written in the snippet,
    commented, for whoever turns the flag on.
2026-10-21 the live box corrects the snippet: rate_limit is not a version number away
    Caddy's experimental features are not registered in a Caddy started without
    --experimental, and caddy run --help does not list that flag at all - so the
    edge rate_limit is not available on this box, and adding it fails the whole
    Caddyfile at load. The snippet now says why, in the file, next to the commented
    block.
    Also documented: the deployment on jarvis (path, container, ports, data, backup
    file), and the end-to-end verification against the live relay - guest post, wall
    pull, owner push, delete with tombstone on both sides, 401 without the key, 404
    for the console and the list through the public name.
2026-10-21 the console moves to the internet: open a URL, connect COM8
    The blocker was never technical. The Node server is not in the frame
    path: the browser generates the frames and hands them to
    navigator.serial itself (web/sinks.js is browser APIs only), and HTTPS
    is a secure context, so a page served from the public name gets
    navigator.serial exactly as http://127.0.0.1:8080 does. COM8 belongs to
    the browser, not to the server. What was missing was an answer to "who
    is allowed to drive the wall", which the loopback bind used to give for
    free.
    So: relay/console.js. A second ROLE on the same container, chosen by the
    Host header, behind a session that IS the owner token.
    wall.hoa.family t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
2026-10-21 the console's relay line says 'the wall last visited', and a browser check proves the claim
    The verb edit had silently not applied (a str.replace that matched nothing,
    which is why the line still read 'synced' with no interval). The live check
    caught it: on the published console the number is when the wall last visited
    THIS machine, which is the only thing it can know.
    scratch/pubconsole-check.mjs drives a real headless Chromium against the live
    https://wall-console.hoa.family: sign in from the form, land in the console,
    watch the sim canvas move, and assert window.isSecureContext plus
    navigator.serial.getPorts - which is the entire premise of publishing the
    console instead of running a loc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
2026-10-21 the serial sink CLOSES a disconnected port: a re-enumerating ESP32 leaked one port per cycle in the browser process, and that is the grey page
2026-10-23 the watchdogs detect, record and revive — they NEVER reload: a reload drops Web Serial (gesture-gated), and the cure was a dark wall
2026-10-24 0.11.1: the relay, from the console dropdown — no command line, ever
    The packaged app made pairing-by-flags a shortcut-flag chore. The
    console's Relay dropdown (Off / wall.hoa.family / Custom) now configures
    the live client over POST /relay, owner-token-gated, and the server
    persists relay.json beside the gallery: set it once, every later boot
    (reboot, restart, bare portable exe with no flags) relays by itself.
    Contracts pinned by test/relay-console.test.js:
    - POST /relay without the owner token is 401: the hand that prunes the
    gallery is the only hand allowed to move the party's plumbing.
    - a half-config (URL, no key) is refused 400 - a relay without a key
    syncs to nothing and only w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
2026-10-24 0.11.2: the app seeds its own owner token into the console
    The owner-token box asked a human to paste a secret that lives one
    file away - and the two installs on this machine (dev repo, packaged
    app) each have THEIR OWN token. Measured: owner pasted the dev token
    into the installed app, got a 401, 'it doesn't work'. The shell knows
    its token file (userData beside the gallery): seed it into the page's
    localStorage (the key draw.html and the relay form share) on every
    load and pre-fill the box. Local-only - the token crosses no network;
    the browser path keeps reading it from the printed log.
2026-10-24 release pipeline: GitHub Actions matrix builds win/linux/mac per tag
    macOS binaries can only be produced on macOS, Linux AppImage/deb want
    real Linux (symlinks, fpm) - so the matrix: windows-latest --win,
    ubuntu-latest --linux, macos-latest --mac. Push a v-tag and the release
    publishes with every binary attached; the Actions tab button builds
    artifacts without a release. npm ci --omit=optional: CI ships zero
    native modules, nothing can ever invoke node-gyp.
2026-10-25 CI signing: the Apple env vars exist ONLY when the secret does
    electron-builder v26 reads an EMPTY CSC_LINK as a certificate PATH -
    the empty string resolves against the project dir: 'LEDWallSimulator
    not a file', mac job dead (measured: v0.11.4). The Anvil pattern's
    'empty means absent' holds for the APPLE_* notarize family, not for
    CSC_LINK. Two conditional build steps: secret present -> sign +
    notarize with the five vars; absent -> clean unsigned with
    CSC_IDENTITY_AUTO_DISCOVERY=false (explicit: a runner's own identities
    must never leak into our artifacts).
2026-10-25 the colon in a yaml plain scalar (my own step name): 'build (unsigned: ...' is a mapping start mid-scalar; quote it
    And the process lesson: the chain pushed a tag on a python-validated-
    first basis, but ';' after a failed validation let git continue. Fix
    validated BEFORE push this time: yml parses, commit, retag v0.11.5
    (force) onto the fix, then push -q origin v0.11.5 && echo
2026-10-25 secrets-local/ gitignored: signing material staged on disk
    Fresh MAC_CERT_P12 minted from the Anvil signing key + Developer ID
    certificate (mac-app.key and developerID_application.cer share one
    modulus - verified), with a generated export password (the old p12's
    password is lost; the keypair makes the old file irrelevant).
    Team ID W4J4G4A96P read from the certificate subject. Everything under
    secrets-local/, which never enters git.
2026-10-25 CI mac runner: pin macos-15 - macOS 26 broke electron-builder's keychain flow
    macos-latest is now macOS 26 (electron-builder logged os=25.6.0): the
    p12 imports (only after -legacy: SHA1/3DES, macOS 'security import'
    rejects OpenSSL 3 defaults), then set-key-partition-list fails with
    SecKeychainUnlock - codesign cannot use the imported identity. Anvil's
    signing releases ran on the then-latest macOS 15; pin it until
    electron-builder catches up with Tahoe.
2026-10-25 macOS serial: a platform-aware picker, POSIX probe/takeover, and the TCC plist that kills the wall
    The released mac app (0.11.6) listed the ESP32 and answered the picker with
    none. Its wall.log has the proof:
    serial request - 3 port(s): {"portName":"cu.Bluetooth-Incoming-Port"} |
    {"portName":"cu.debug-console"} | {"portName":"cu.usbmodem59810005071",
    "displayName":"USB Single Serial","vendorId":"6790","productId":"21971",...}
    -> none chosen (refused)
    Three independent causes, all Windows-shaped:
    - THE PICKER. select-serial-port compared vendorId against hex strings
    ('1a86'); macOS reports DECIMAL ('6790' = 0x1a86), matched nothing, and the
    fallback tested /^com\d+$/i against a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
2026-10-25 wall flicker: a flat field puts the fault on the beads' side of the pin
    Symptom: on the mac, a few LEDs flicker other colours, ~99% of the wall is
    fine; the same wall, cable and firmware on Windows is stable.
    Measured on this panel, not guessed:
    - The app streams at a fixed 30 fps and lands byte-perfect (disc=0 resync=0,
    decoded == written). 42 and 45 fps do too.
    - 60 fps collapses: 36 of 57 frames/s decoded, disc~10/s, gaps~10/s, resync
    1000-4000/s. 400 APA106 beads are 30 bits at a ~1.7 us bit, so one refresh
    is ~20 ms of wire: ~49 fps is the ceiling, and the app's 30 is the right
    number, not a conservative one.
    - A FLAT FIELD is the discriminator: the host sends the same 1200 byt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
2026-10-25 macOS: findChrome() could never find a browser, so --page and /capture were dead
    Three things have to line up to locate a Chromium, and on macOS the list had all
    three wrong: the ROOT (Playwright's cache is ~/Library/Caches/ms-playwright on
    macOS, not ~/.cache), the DIRECTORY a build unpacks to (chrome-mac-arm64 on Apple
    Silicon, chrome-mac-x64 on Intel, chrome-mac only in older Playwright), and the
    EXECUTABLE inside it (current builds ship 'Google Chrome for Testing.app', not
    Chromium.app).
    On a Mac with no Chrome installed that Playwright Chromium IS the browser, so
    every capture route answered 'no Chrome/Edge/Chromium found - set LED_CHROME':
    --page, the /capture route, and every test in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
2026-10-25 wall flicker: the colours say how many bits are late, and the low runs say why
    Blue showing red, red showing green, at fixed beads, some flickering. Those are
    byte-aligned shifts, and they are diagnostic. In this wall's BGR order a red bead
    is B=0x00 G=0x00 R=0xFF, and a BRIGHT green needs 0xFF in the green slot: the red
    byte landing there, one byte late. A blue bead is B=0xFF G=0x00 R=0x00, and blue
    showing red is two bytes late. A bead drops whole bytes when its latch resets
    mid-frame and it re-latches from the next edge, then passes the remainder
    downstream shifted - which is what a run of beads, i.e. a "column" of the 20x20
    matrix, is.
    What resets the latch is the LOW RUN, and that is a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
2026-10-25 macOS: add Helium to the browser list - it is the Chromium a show Mac has
    The macOS install list in findChrome() had Chrome, Chrome Canary, Chromium, Edge
    and Brave. The Macs in this project run Helium, a Chromium browser, so a Mac with
    no Chrome installed and no node_modules - which is the PACKAGED app on a show
    machine, with no Playwright cache to fall back on - had no browser at all, and
    --page and the /capture route answered "no Chrome/Edge/Chromium found - set
    LED_CHROME".
    Measured on this Mac, with the Playwright cache hidden so the packaged app's
    situation is the one being tested:
    env -u LED_CHROME HOME=/tmp/empty-home node -e "... findChrome()"
    -> /Applications/Helium.app/Con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
2026-10-25 flicker.js: gaps is metadata visibility, not a wire fault
    The rig's noteGap() counts a status window in which frames arrived and NO meta
    frame did (statusFrames > 0 && !statusMetaSeen). The tool was adding gaps into
    its loss total and labelling it "bytes/frames not landing", which is the opposite
    of what it means: a sender that sends frames and no metas ticks gaps once a
    second by construction.
    This was not a theoretical catch. I read gaps=+30/s from a 42 fps burst run as
    evidence that the arrival pattern stresses the wire, and said so out loud. The
    same rate and bytes, sent with a meta per second (scratch/pace-ab.mjs, 30 fps
    flat red, spaced vs bursts of 3, 450/450 decoded both ways) repor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
2026-10-25 macOS flicker: it is the serial driver, and every counter was clean on both
    The wall flickers on the mac and not on Windows. Same cable, same beads, same
    firmware, same power, same ground bond. The cause is the host's serial driver:
    macOS claims the ESP32-S3's USB-CDC with the generic AppleUSBACMData, where
    Windows uses WCH's vendor driver. Installing WCH's driver on the mac removes the
    seams completely. That is the whole fix, and it is a driver install, not code.
    What made this expensive is that EVERY digital counter is clean on BOTH drivers.
    On the Apple driver, with seams plainly visible on the wall: decoded == written,
    disc=0 resync=0, at 8/15/30/30.5/31/32/33/42/45 fps, spaced and burs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
2026-10-26 pumpkin: a jack-o'-lantern for Halloween, and the wall renders ONE animation library
    The animation: a fat ridged pumpkin on a night sky, a candle flickering
    inside it (the noise field sampled along the time axis - pure, every
    renderer in lockstep), triangle eyes closing toward a toothed zigzag
    grin, and one bat flapping across the top per 34 s cycle.
    The sky fix from the field report 'the background flickers pink to
    blue': the old sky was purple (red over green) and the star twinkle
    bottomed out BELOW the sky, so every star cell opened a dark hole and
    closed it again - a brightness inversion reads as a colour flicker.
    The sky is night blue, and twinkle stays in [0.24, 1.0]: stars
    shimmer, n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
2026-10-26 brightness: the preview ignores the clamp, and the slider is bidirectional
    Three field reports, one honest brightness path:
    The preview shows the wall's EXPECTED VIEW: draw() paints the raw
    wire bytes (packed), not the power-scaled copy. A preview that dims
    with the budget reads as the content changing when only the clamp
    moved; k and the mA readouts live on the power line, where a clamp
    belongs.
    The slider latched into the ratchet - 'requested brightness does
    absolutely nothing': brightnessFor folded the requested k INTO the
    one-way adaptive ceiling, so dragging the wall down worked once and
    min(want, this.k) pinned the wall at the old low forever. The
    ratchet now covers the POWER CEILING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
2026-10-27 colour: the LED fine-tune is the wall's, not the preview's
    Saturation and gamma are properties of the PHYSICAL wall - they
    compensate for the diffuser washing a pastel to white and for the
    beads' own response - so tuning them must not move the picture on
    screen. They were applied to panel.pixels before packing, and the
    preview draws the packed bytes, so an operator fine-tuning the wall
    watched the design change instead.
    The fix is an ordering change, not a second code path: packing is a
    permutation of whole pixels and both operations are per-pixel, so
    tuning AFTER the pack is byte-for-byte identical to tuning before
    it. The pipeline now packs the design, snapshots it into `preview`,
    then tu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
2026-10-27 colour: white balance and black level, the two corrections the wall needed
    The fine-tune panel held saturation and gamma. Both fix the wall's own
    behaviour, but two physical faults had no lever at all.
    White balance. The beads' R/G/B dies have different efficiencies, so
    "white" at 255,255,255 is never neutral, and every colour inherits the
    cast. Saturation cannot fix it (it is hue-preserving) and gamma cannot
    (it is per-channel but symmetric). whiteBalanceGains() is the standard
    camera pair - temperature (cool..warm) and tint (green..magenta) - as
    relative channel gains.
    The gains are CUT-ONLY: normalised so the largest is 1.0. A channel
    cannot be driven past full, so the only way to rebal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
2026-10-27 settings: the wall's calibration persists, and the markup carries it
    The power budget (limit, brightness, headroom) and the LED fine-tune
    (saturation, gamma, temperature, tint, black level) are properties of the
    HARDWARE, dialed once per wall by looking at the wall. They were
    per-session only: a reload - or a Ctrl+Shift+R - brought the wall back
    dim and colour-cast until someone re-dialed it, and the sliders showed no
    numbers to re-dial FROM.
    Persist all eight to localStorage on every input and restore them before
    the first frame, so the budget carries the restored limit and the
    auto-reconnect's first meta is right. Restores are clamped to each
    control's own range, a malformed key falls bac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
2026-10-27 release: 0.12.0 - a pumpkin, an honest brightness path, and the LED fine-tune
    Bumps to 0.12.0. What is in it, since 0.11.7:
    - pumpkin: a jack-o'-lantern for Halloween, and the wall renders ONE
    animation library. content.html carried a hand-copied ~250-line canvas
    switch of every animation beside the pure core generator the frame driver
    uses, with no test comparing them; animDraw now paints animFrame output
    through the same paintBytes the gallery uses, so the page and the wall are
    the same bytes by construction. The sky flicker report ('pink to blue')
    was the star twinkle bottoming out BELOW the sky - a brightness inversion
    reads as a colour flicker; the sky is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
2026-10-27 docs: what tonight actually taught — counters are blind past the data pin
    A field report of "the wall is dim" took a long detour through a level
    shifter and a power-supply theory before a bad Dupont jumper on the data
    line was found by swapping it. The docs were not just silent on that —
    some were actively misleading, so this corrects them as well as adding
    the lesson.
    firmware/README.md
    - The wiring diagram showed GPIO27 through a level shifter as if that
    were this wall. It is an S3 on GPIO21, running DIRECT, measured good
    at br=255 on all four channels. The shifter is optional immunity; the
    ESP32 board has none built in, which is a fact about the board, not
    evidence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
2026-10-27 gallery: a guest drawing joins the queue instead of resetting the show
    Field report: submitting a drawing makes the gallery skip to it and carry
    on. With several guests drawing at speed the show never settles.
    The cause was arithmetic. A slot was
    floor((t mod (count * period)) / period), so the MODULUS carried the list
    length and a guest controlled it: the moment the list grew, every slot
    boundary re-anchored against absolute time. The drawing on the wall
    changed mid-slot, a break appeared where a drawing was showing, and a
    transition fired for it. Reproduced as 154 jump instants in the first 200
    seconds of an 8s+5s cadence.
    Three changes, in order of how much each was worth:
    1. A slot is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
2026-10-27 gallery: which drawing is on screen is remembered, not derived
    Two field reports, one cause: 'slot mod count' indexes a mutable roster, so a
    guest submitting made the show skip to it and an owner pruning made drawings
    come round twice. The fact 'what is on screen now' is not in the list, so it
    is now stored: DrawingStore keeps a queue of permanent positions and a cursor
    that pins the slot's drawing by id, advanced at read time (catch-up, so a wall
    restarted after a night lands where its clock says). The schedule rides the
    /content poll every renderer already makes.
    A boundary that lands on a pruned drawing's hole steps on to the next live
    position: the hole keeps its place in the lap, so no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
2026-10-27 release: 0.13.0 - the show remembers its drawing, and a delete costs one slot
    Bumps to 0.13.0. What is in it, since 0.12.0:
    - gallery: which drawing is on screen is REMEMBERED, not derived. The
    rotation used to be arithmetic over the roster, and an index re-bases
    whenever the roster does: a guest submitting made the show skip to the
    newcomer, an owner pruning made drawings come round twice. The store now
    keeps a queue of permanent positions and a cursor pinning the slot's
    drawing by id, advanced at read time - a wall restarted after a night
    lands where its own clock says. The schedule rides the /content poll
    every renderer already makes: no second request, no s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
2026-11-08 player: the wall plays a baked show when the laptop is gone
    The browser is the brain, and that is the right default - the fonts, the
    canvas, the drawings and the editor all live there. It has one failure mode
    the wall cannot forgive: a tab closes, a machine sleeps, a cable is knocked,
    and a wall six months into being a family noticeboard goes black in 1.5 s in
    the middle of a party, with nothing to fall back on.
    The renderer stayed on the host on purpose. layout.js and color.js are not
    utilities, they are this panel's measured calibration, and a C++ copy is two
    chances for the baked picture and the streamed one to disagree in a way
    nobody sees until the wall is the wrong colour. So a baked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
